nohponex/arduino-GSM-remote-control/README.md

arduino-GSM-remote-control
==========================

Remote controll usign Arduino &amp; Arduino GSM Module

Scematic
