nohponex/arduino-GSM-remote-control/(list of files, drawings)

Other design files:
Sketches/Arduino GSM-Control-Circuit.fzz
Sketches/Arduino GSM.fzz
